GeDeAr219/Embedded_Project/proteus.jpeg

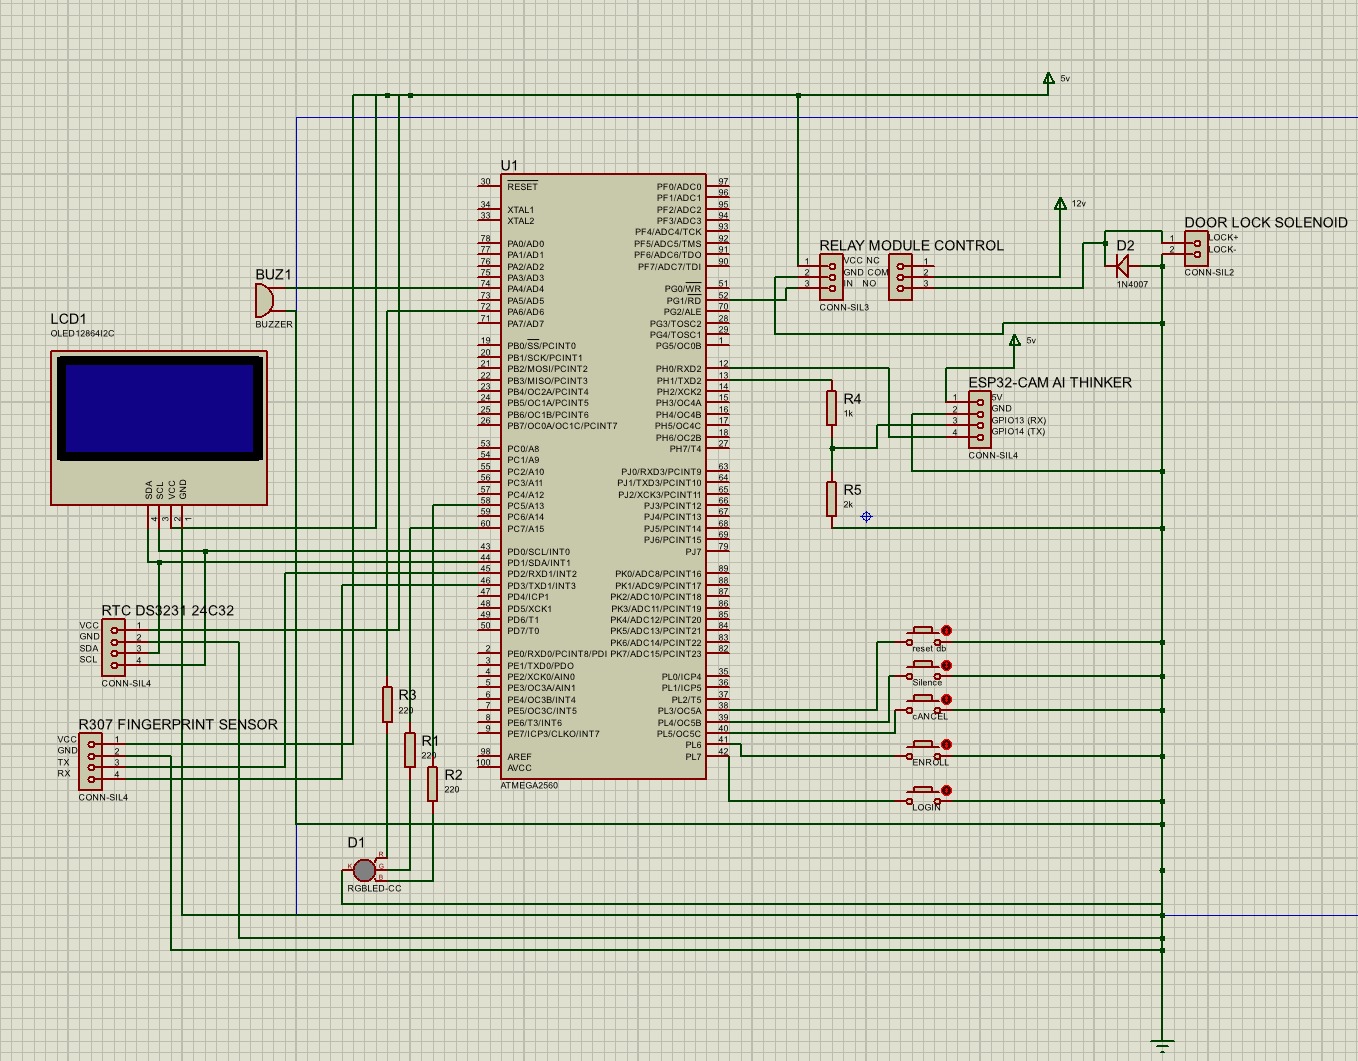
proteus.jpeg
