GeDeAr219/Embedded_Project/(commit log)

2026-05-23 Add Python modules: enrollment, log viewer, WiFi server
    - enroll.py: face enrollment via ESP32-CAM
    - view_logs.py: access log viewer + CSV export
    - wifi_server.py: HTTP server for WiFi face check
    - main.py: integrated WiFi server on startup
2026-05-31 Add Arduino sketch: fingerprint, OLED, log, lock control
    - config.h: pin definitions
    - BiometricSecurity.ino: main state machine
    - fingerprint.ino: enrollment and verification
    - access_log.ino: EEPROM log + RTC
    - oled_display.ino: display helpers
2026-06-04 ESP32CAM esp kodu, FingerprintTest.ino mega tüm kod. diğer kodları temizleriz
2026-06-09 Revert "reset database"
    This reverts commit 6a478aff2c82252187e1128808b665c38fcedde8.
    [ESP32CAM_Face.ino, FingerprintTest.ino]
